Engarix/RoboSphere/Thesis/images/Movement.png

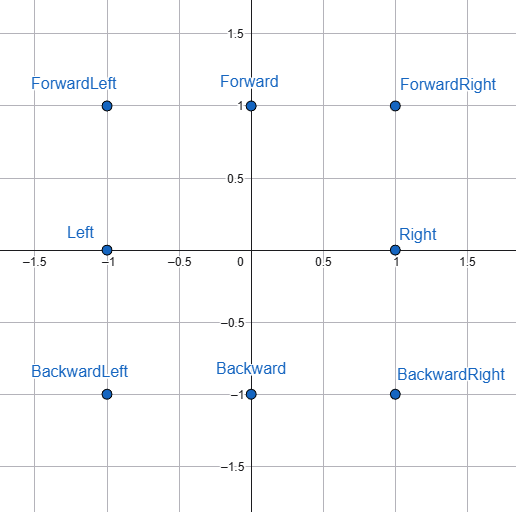
Thesis/images/Movement.png
