Engarix/RoboSphere/3D Printer Files/Lock.stl

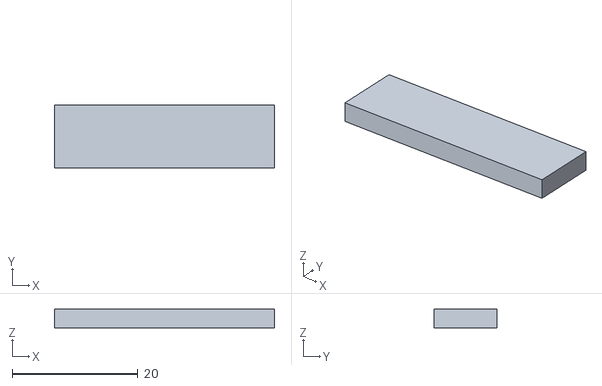
[picture p14: CAD file, 2026-02-19]
3D Printer Files/Lock.stl
35.0 x 10.0 x 3.00
