Engarix/RoboSphere/3D Printer Files/Bridge.stl

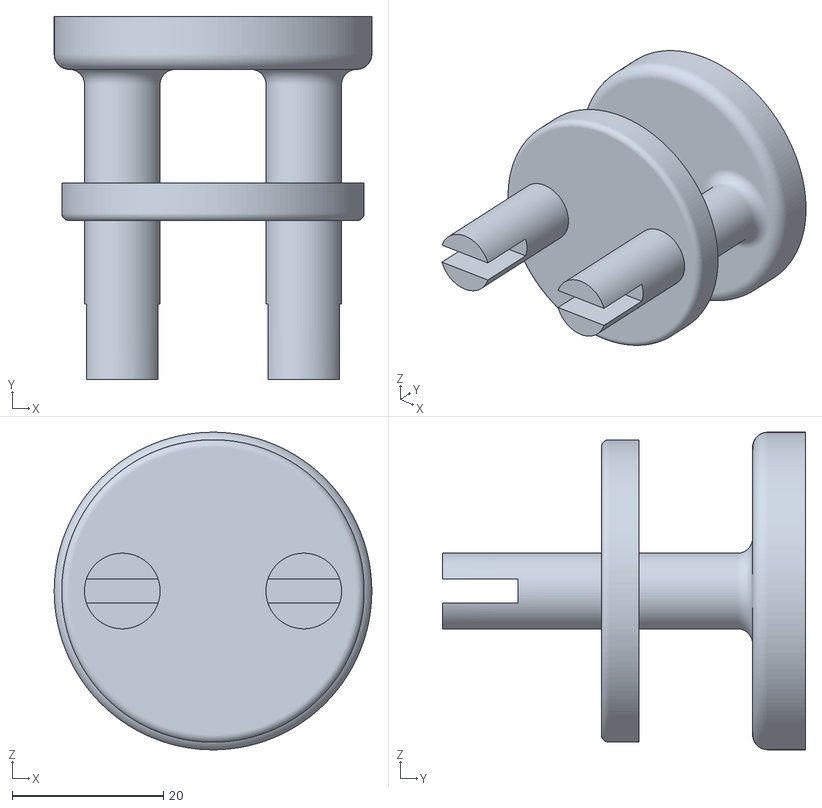
[picture p15: CAD file, 2026-02-19]
3D Printer Files/Bridge.stl
42.0 x 48.0 x 42.0
