Engarix/RoboSphere/3D Printer Files/Handle.stl

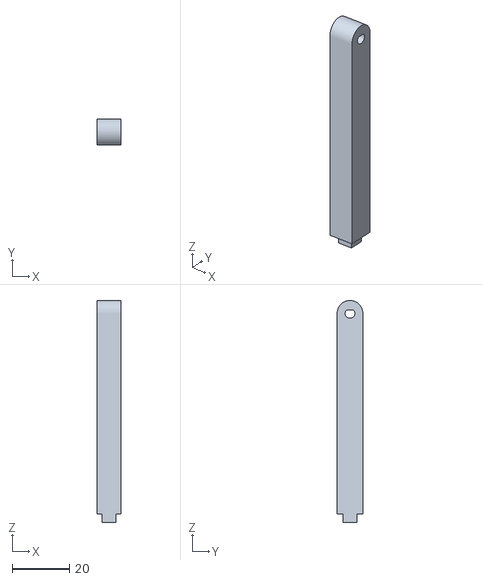
[picture p16: CAD file, 2026-02-07]
3D Printer Files/Handle.stl
8.50 x 9.00 x 77.5
