Engarix/RoboSphere/3D Printer Files/Bryła1.stl

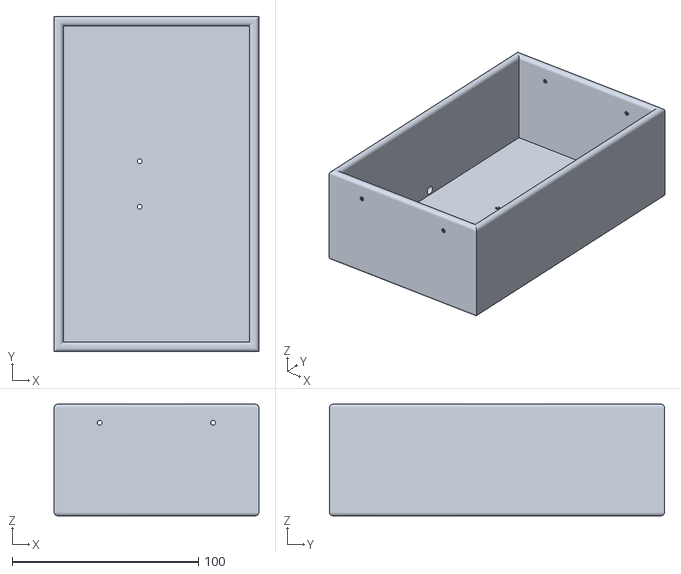
[picture p17: CAD file, 2026-01-29]
3D Printer Files/Bryła1.stl
110.0 x 180.0 x 60.0
