Engarix/RoboSphere/3D Printer Files/Pendulum_Hook.stl

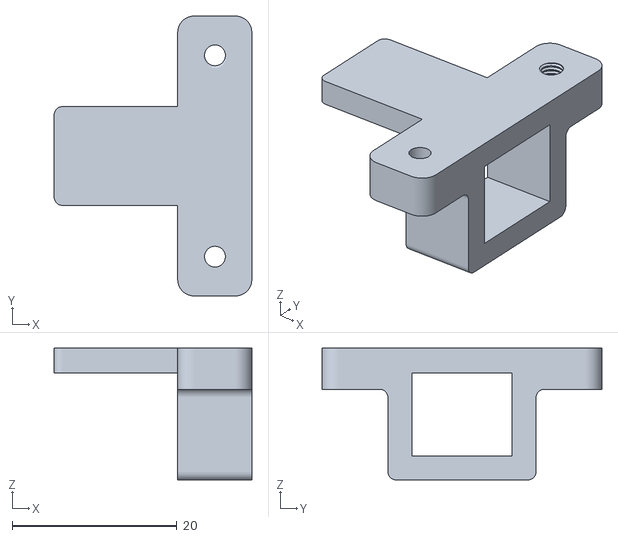
[picture p18: CAD file, 2026-01-29]
3D Printer Files/Pendulum_Hook.stl
24.0 x 34.0 x 16.0
