Engarix/RoboSphere/3D Printer Files/MotorBox.stl

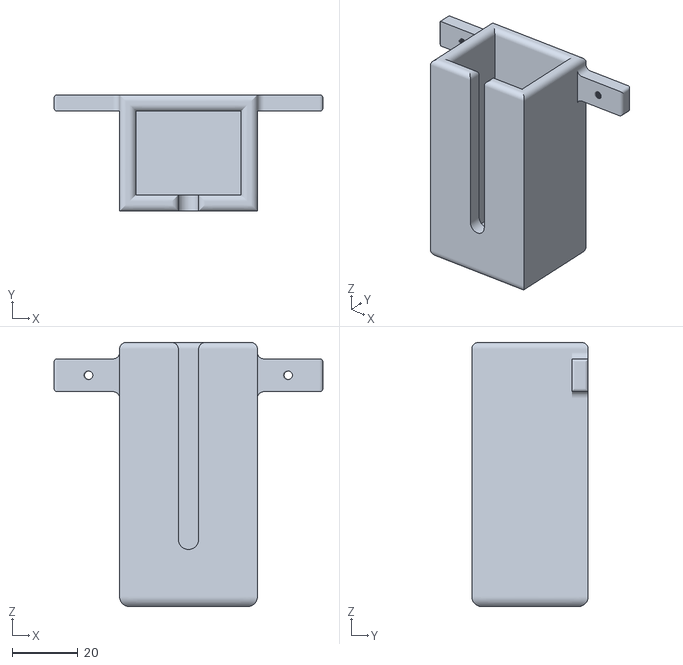
[picture p19: CAD file, 2026-01-06]
3D Printer Files/MotorBox.stl
82.0 x 35.5 x 80.5
