Engarix/RoboSphere/3D Printer Files/D_L.stl

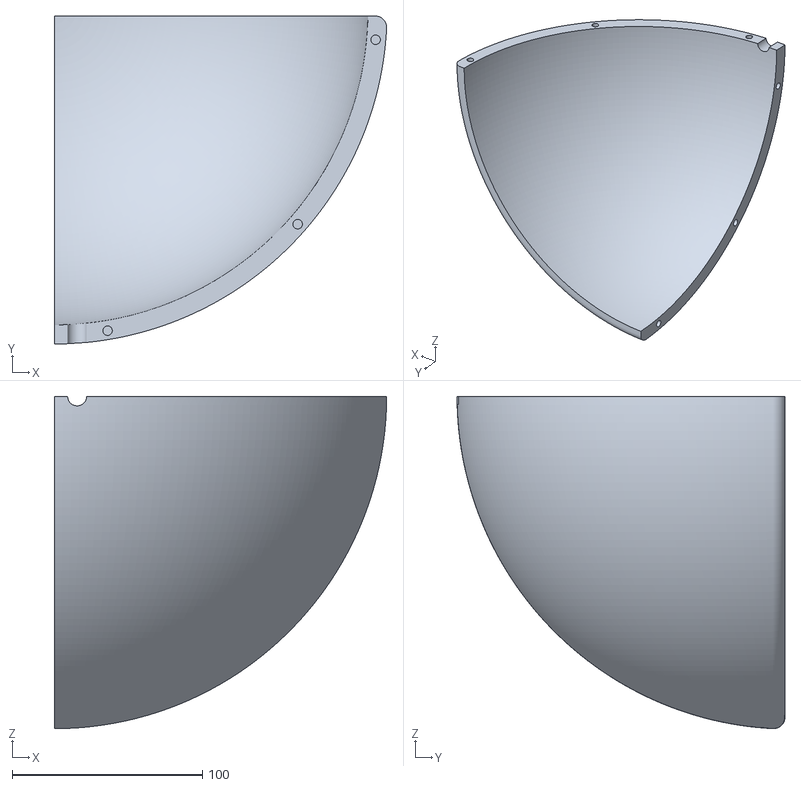
[picture p20: CAD file, 2026-01-06]
3D Printer Files/D_L.stl
174.8 x 172.5 x 174.8
