Engarix/RoboSphere/3D Printer Files/Pendulum_Door.stl

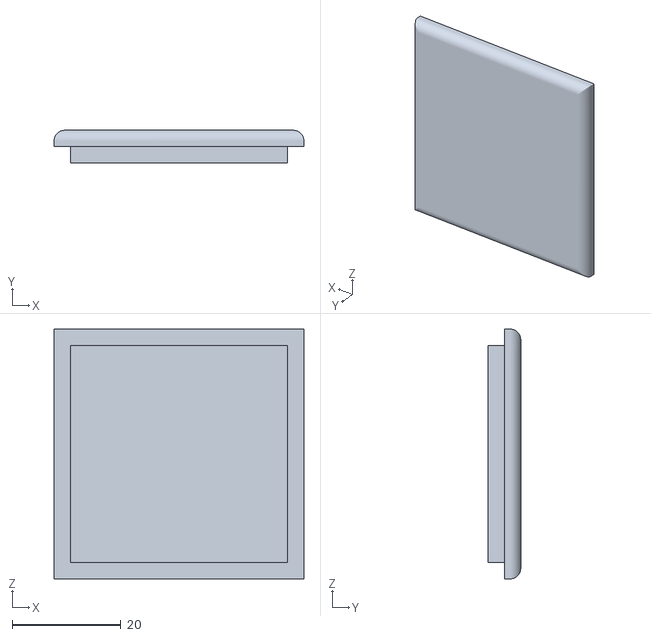
[picture p21: CAD file, 2026-01-06]
3D Printer Files/Pendulum_Door.stl
46.0 x 6.00 x 46.0
