Engarix/RoboSphere/3D Printer Files/Hammer.stl

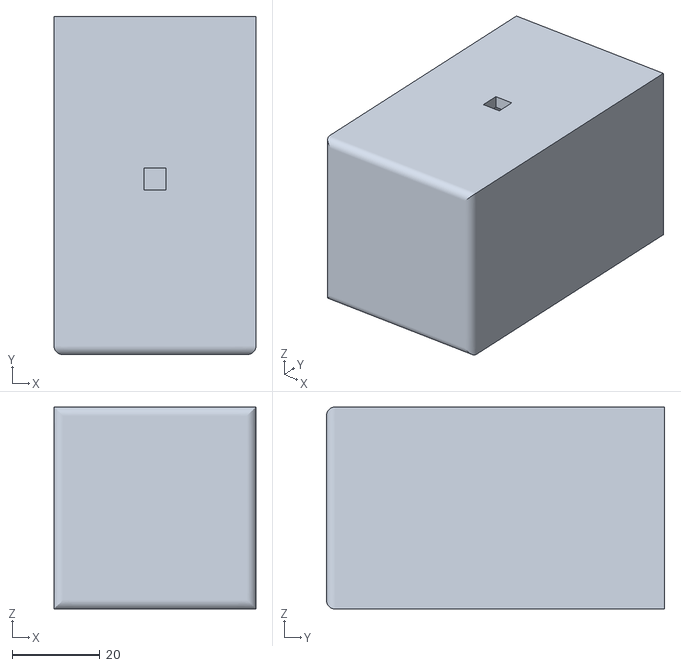
[picture p22: CAD file, 2026-01-06]
3D Printer Files/Hammer.stl
46.0 x 77.0 x 46.0
