Engarix/RoboSphere/(list of files, cad)

Other CAD files:
3D Printer Files/Box.stl
