Engarix/RoboSphere/RoboSphere/RoboSphere.kicad_pcb

## KiCad design RoboSphere/RoboSphere.kicad_pcb (2025-12-15)

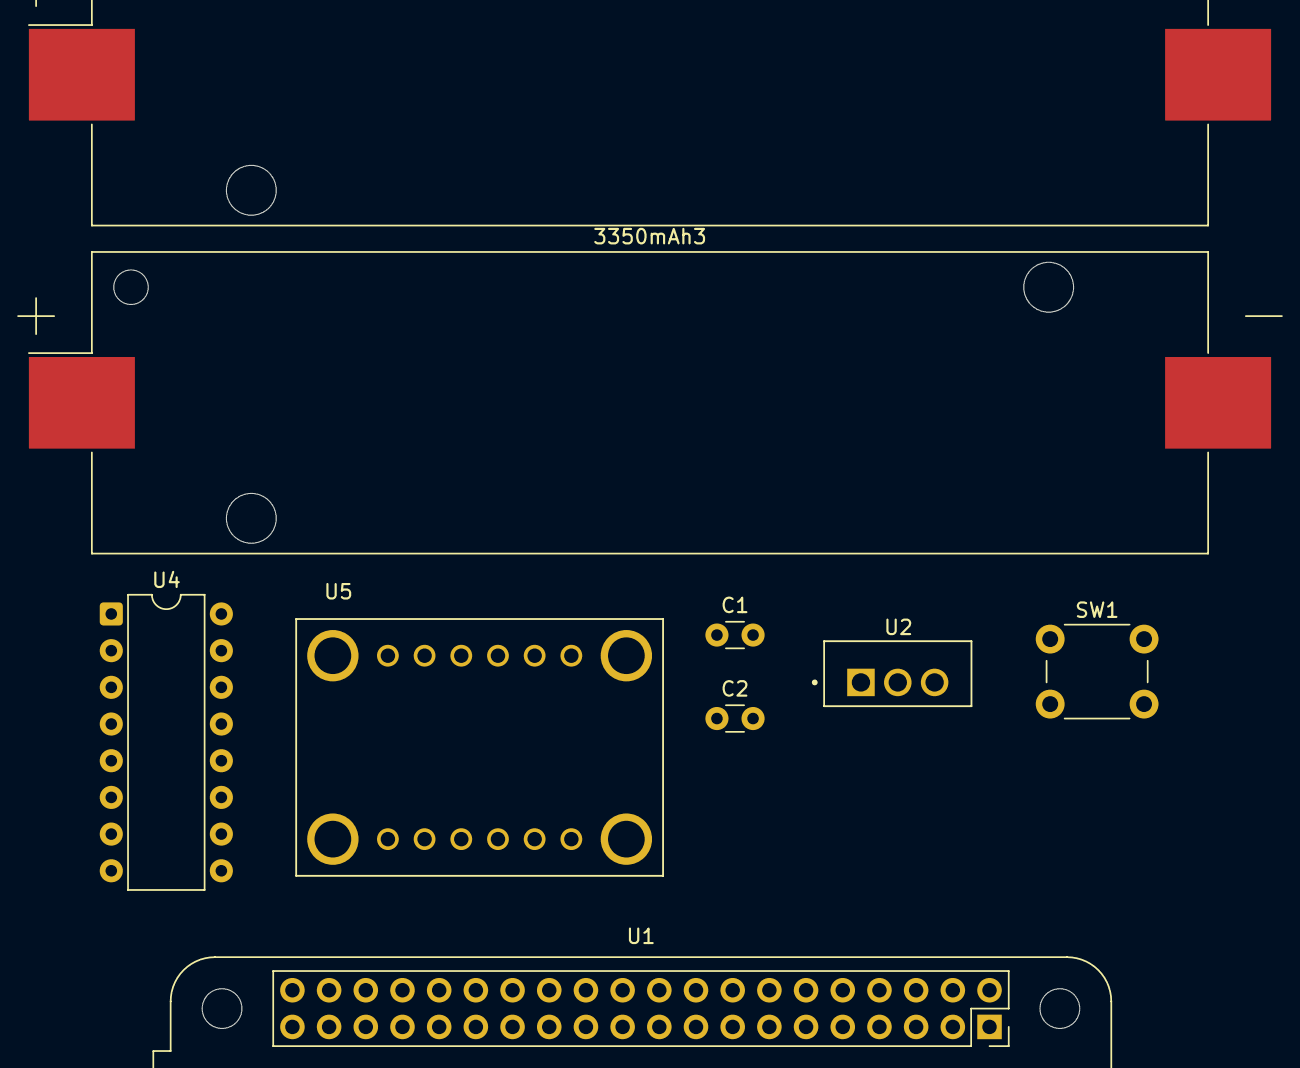
[picture p27: board RoboSphere.kicad_pcb from above]

Board: 2 copper layers, 9 parts (0 on the bottom side), 16 nets, no tracks yet.

Parts:
3350mAh2, 3350mAh3: 3.7V; BatteryHolder_Keystone_1042_1x18650
C1, C2: C; C_Disc_D3.0mm_W1.6mm_P2.50mm
SW1: SW_Push; SW_PUSH_6mm
U1: RASPBERRY_PI_ZERO_2_W; Raspberry_Pi_Zero_Socketed_THT_FaceDown_MountingHoles
U2: L7806; TO255P1020X450X1968-3B
U4: L293D; DIP-16_W7.62mm
U5: ADS1115 1085; MODULE_1085

Connections:
+6V: C2.2, U2.3 (OUT)
+7.5V: C1.2, SW1.2, U2.1 (IN), U4.8 (VCC2), U4.16 (VCC1), U5.JP1_5 (A0)
GND: 3350mAh2.2 (-), C1.1, C2.1, U2.2 (GND), U4.4 (GND), U4.5 (GND), U4.12 (GND), U4.13 (GND), U5.JP2_2 (GND), U5.JP2_5 (ADDR)
unnamed: 3350mAh2.1 (+), 3350mAh3.2 (-)
unnamed: 3350mAh3.1 (+), SW1.1
unnamed: U1.1 (3V3_1), U5.JP2_1 (VIN)
unnamed: U1.3 (GPIO2/SDA1), U5.JP2_4 (SDA)
unnamed: U1.5 (GPIO3/SCL), U5.JP2_3 (SCL)
unnamed: U1.29 (GPIO5), U5.JP2_6 (ALRT)
unnamed: U1.26 (GPIO7/SPI_~CE1), U4.15 (4A)
unnamed: U1.24 (GPIO8/SPI_~CE0), U4.10 (3A)
unnamed: U1.33 (GPIO13), U4.9 (EN3,4)
unnamed: U1.35 (GPIO19), U4.1 (EN1,2)
unnamed: U1.16 (GPIO23/GPIO_GEN4), U4.2 (1A)
unnamed: U1.18 (GPIO24/GPIO_GEN5), U4.7 (2A)
unnamed: U5.SH1 (SHIELD), U5.SH2 (SHIELD), U5.SH3 (SHIELD), U5.SH4 (SHIELD)
