Engarix/RoboSphere/(commit log)

2025-03-26 KiCad Start
    [RoboKula.kicad_pcb, RoboKula.kicad_sch]
2025-04-12 KiCad Update
    [RoboKula.kicad_pcb, RoboKula.kicad_sch]
2025-04-12 KiCad Update 0.2
    [RoboSphere.kicad_pcb, RoboSphere.kicad_sch]
2025-04-15 Kicad H-bridge update
    [RoboSphere.kicad_pcb, RoboSphere.kicad_sch]
2025-04-18 Power Converter Module
    [RoboSphere.kicad_pcb, RoboSphere.kicad_sch]
2025-04-18 Power % module
    [RoboSphere.kicad_sch]
2025-04-19 Setting values
    [RoboSphere.kicad_sch]
2025-04-19 Power Management Updates
    [RoboSphere.kicad_sch]
2025-05-24 Power module update & ADC
    [RoboSphere.kicad_sch]
2025-10-28 Finished Version 1
    [RoboSphere.kicad_pcb, RoboSphere.kicad_sch]
2025-11-03 Updated schematic with placement organization
    [RoboSphere.kicad_pcb, RoboSphere.kicad_sch]
2026-01-02 Printer Files
    [Box.stl, Bridge.stl, MotorBox.stl, Pendulum.stl, Pendulum_Door.stl, Pendulum_Hook.stl]
2026-01-06 Update on 3d model
    [D_L.stl, Hammer.stl, Handle.stl, MotorBox.stl, Pendulum.stl, Pendulum_Door.stl]
2026-01-11 Thesis V1 (still needs pictures and modified power module)
2026-01-29 Bigger pin, screw holes
    [Bryła1.stl, Handle.stl, Pendulum_Hook.stl, U_L.3mf]
2026-02-07 3D prints update
    [Bridge.stl, Handle.stl, U_L.3mf]
2026-02-19 Bridge 3.0 & Lock
    [Bridge.stl, Lock.stl]
